MikePythons/TinyTinyProg/UPDIsmol.kicad_pcb

## KiCad design UPDIsmol.kicad_pcb (2021-12-29)

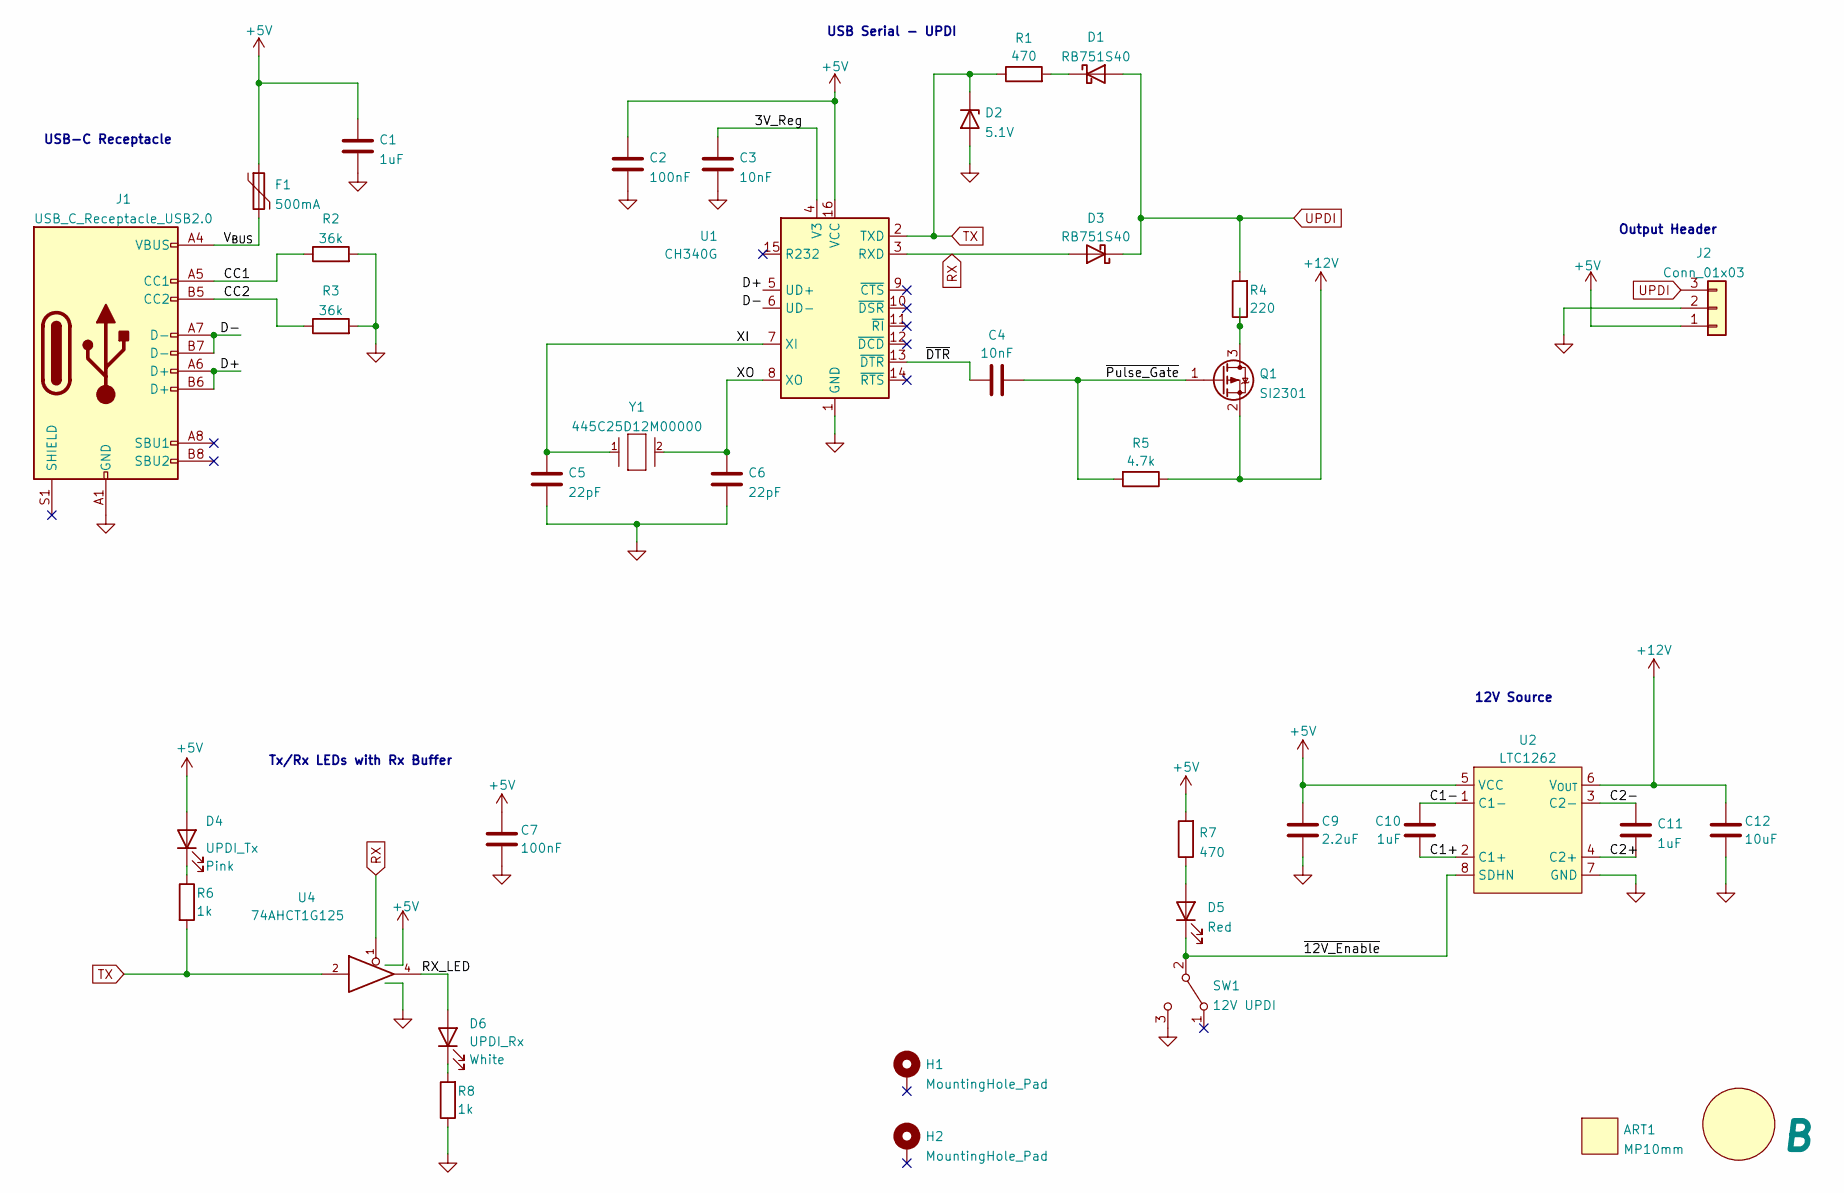
[picture p1: schematic UPDIsmol.kicad_sch]

Parts:
ART1: MP10mm; MPSquare_10mm
C1: 1uF; C_0603_1608Metric; Part CGA3E1X7R1C105K089AC
C2, C7: 100nF; C_0603_1608Metric
C3, C4: 10nF; C_0603_1608Metric
C5, C6: 22pF; C_0603_1608Metric
C9: 2.2uF; C_1206_3216Metric
C10, C11: 1uF; C_0805_2012Metric; Part 08055D105KAT2A
C12: 10uF; C_1206_3216Metric; Part GMK316BJ106ML-T
D1, D3: RB751S40; D_SOD-523
D2: 5.1V; D_MiniMELF
D4: UPDI_Tx; LED_0603_1608Metric
D5: Red; LED_0603_1608Metric
D6: UPDI_Rx; LED_0603_1608Metric
F1: 500mA; Fuse_1206_3216Metric_Pad1.42x1.75mm_HandSolder
H1, H2: MountingHole_Pad; MountingHole_2.2mm_M2_DIN965_Pad
J1: USB_C_Receptacle_USB2.0; USB_C_Receptacle_Palconn_UTC16-G
J2: Conn_01x03; PinHeader_1x03_P2.54mm_Horizontal
MISC1: B; RevisionSymbol
Q1: SI2301; SOT-23
R1, R7: 470; R_0603_1608Metric
R2, R3: 36k; R_0603_1608Metric
R4: 220; R_0603_1608Metric
R5: 4.7k; R_0603_1608Metric
R6, R8: 1k; R_0603_1608Metric
SW1: 12V UPDI; SW_SPDT_PCM12
U1: CH340G; SOIC-16_3.9x9.9mm_P1.27mm
U2: LTC1262; SOIC-8_3.9x4.9mm_P1.27mm
U4: 74AHCT1G125; SOT-553
Y1: 445C25D12M00000; Crystal-CTS-445-0-0-0; mouser part number 774-445C25D12M00000; digikey description CRYSTAL 12.0000MHZ 18PF SMD

Connections:
+5V: C1.2, C2.2, C7.2, C9.2, D4.2 (A), F1.1, J2.1, R7.2, U1.16 (VCC), U2.5 (VCC), U4.5 (5V)
+12V: C12.2, Q1.2 (S), R5.1, U2.6 (V_{OUT})
/3V_Reg: C3.2, U1.4 (V3)
/C1+: C10.1, U2.2 (C1+)
/C1-: C10.2, U2.1 (C1-)
/C2+: C11.1, U2.4 (C2+)
/C2-: C11.2, U2.3 (C2-)
/CC1: J1.A5 (CC1), R2.1
/CC2: J1.B5 (CC2), R3.1
/D+: J1.A6 (D+), J1.B6 (D+), U1.5 (UD+)
/D-: J1.A7 (D-), J1.B7 (D-), U1.6 (UD-)
/RX_LED: D6.2 (A), U4.4
/V_{BUS}: F1.2, J1.A4 (VBUS), J1.A9 (VBUS), J1.B4 (VBUS), J1.B9 (VBUS)
/XI: C5.2, U1.7 (XI), Y1.1
/XO: C6.2, U1.8 (XO), Y1.2
/~12V_Enable: D5.1 (K), SW1.2 (B), U2.8 (SDHN)
/~DTR: C4.1, U1.13 (~DTR)
/~Pulse_Gate: C4.2, Q1.1 (G), R5.2
GND: C1.1, C2.1, C3.1, C5.1, C6.1, C7.1, C9.1, C12.1, D2.2 (A), J1.A1 (GND), J1.A12 (GND), J1.B1 (GND), J1.B12 (GND), J2.2, R2.2, R3.2, R8.1, SW1.3 (C), U1.1 (GND), U2.7 (GND), U4.3 (GND)
unnamed: D1.1 (K), R1.2
unnamed: D4.1 (K), R6.1
unnamed: D5.2 (A), R7.1
unnamed: D6.1 (K), R8.2
unnamed: Q1.3 (D), R4.1
RX: D3.2 (A), U1.3 (RXD), U4.1
TX: D2.1 (K), R1.1, R6.2, U1.2 (TXD), U4.2
UPDI: D1.2 (A), D3.1 (K), J2.3, R4.2

Notes on the sheet:
Output Header
USB Serial - UPDI
USB-C Receptacle
12V Source
Tx/Rx LEDs with Rx Buffer

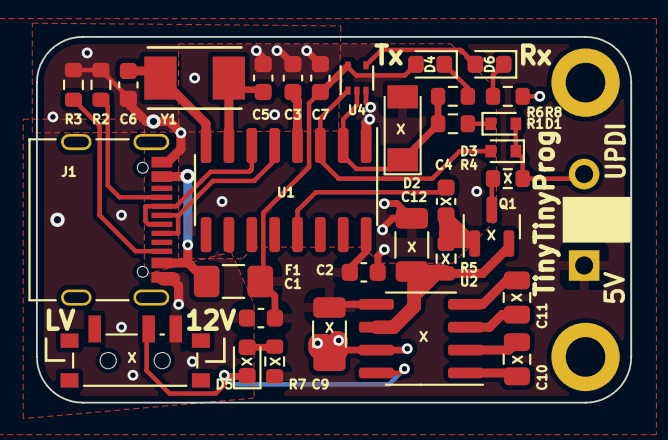
[picture p2: board UPDIsmol.kicad_pcb from above]

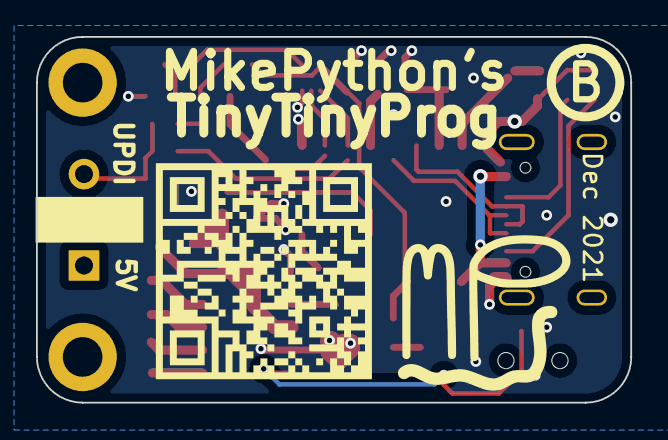
[picture p3: board UPDIsmol.kicad_pcb from below]

Board: 2 copper layers, 33.0 x 20.3 mm, 38 parts (3 on the bottom side), 27 nets.
