MikePythons/TinyTinyProg/(commit log)

2021-12-29 Revision B. Updated silkscreen + correct MOSFET footprint orientation.
    [UPDIsmol.kicad_pcb, UPDIsmol.kicad_sch]
2022-01-19 Tidied schematic, still RevB
    [UPDIsmol.kicad_sch]
